karlxia/remoteDataAcquisition/RDAReporte/毕设相关PDF文档/附录PDF/RDApcb.pdf

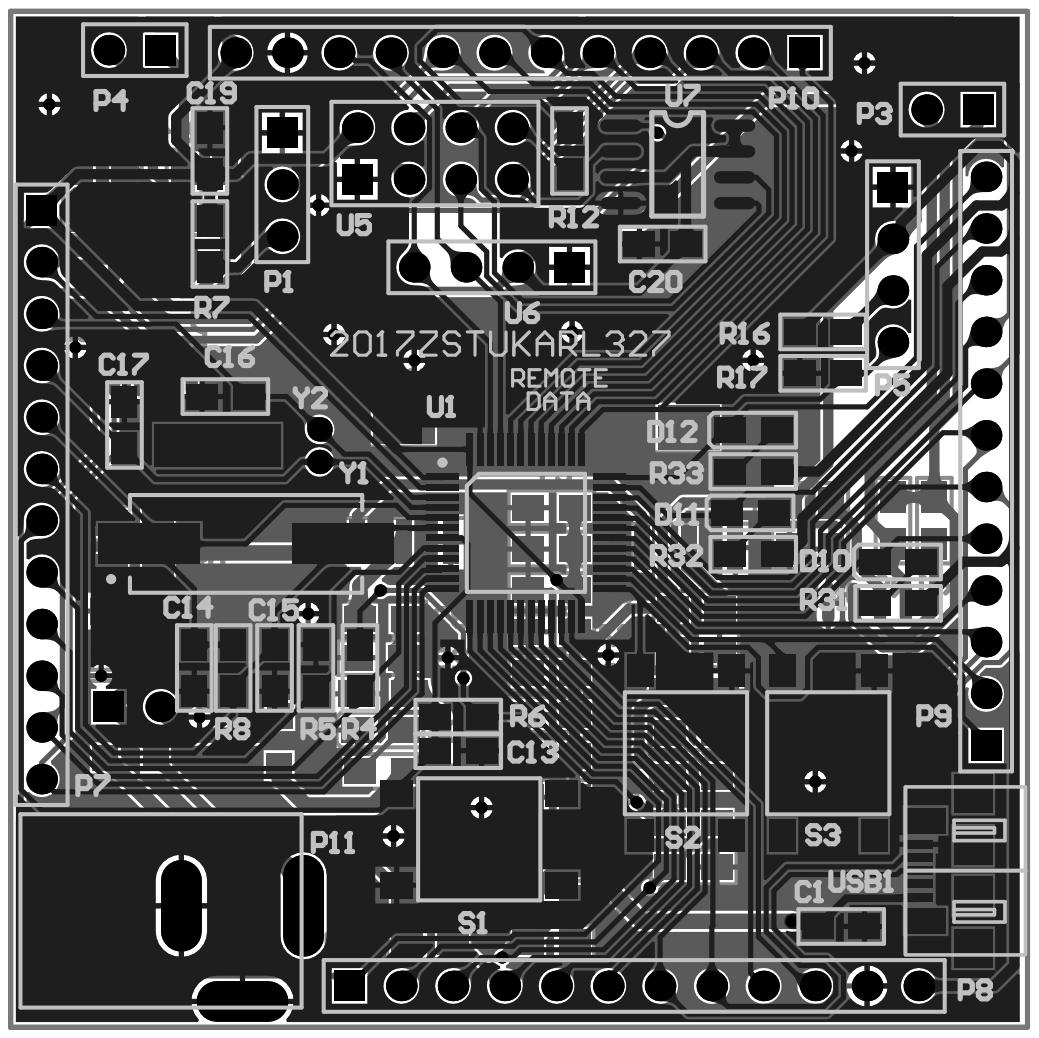
[picture p51: page 1]
