karlxia/remoteDataAcquisition/RDAReporte/毕设相关PDF文档/附录PDF/RDAsch.pdf

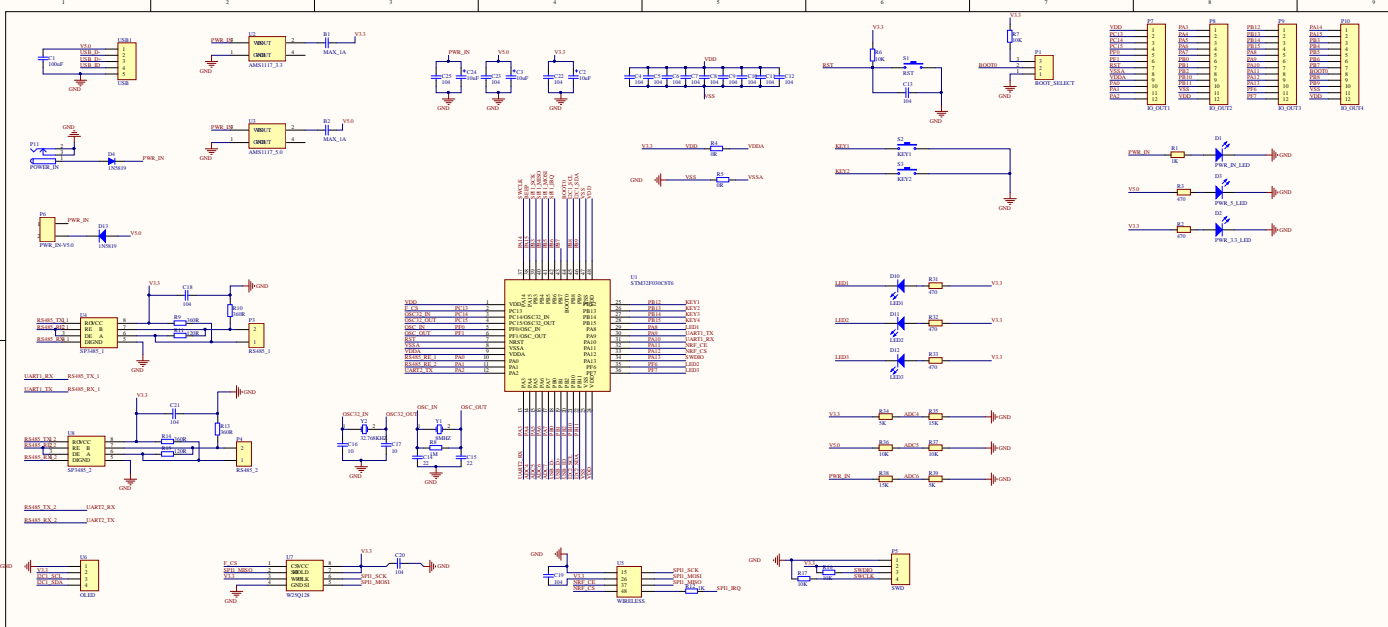
[picture p52: page 1]
