karlxia/remoteDataAcquisition/RDACode/SYSTEM/usart/usart.h

#ifndef __USART_H
#define __USART_H
#include "stdio.h"	
#include "sys.h" 
#include "stm32f0xx_hal.h"
#include "stm32f0xx_karlboard.h"

#define USART_REC_LEN  			200  	//定义最大接收字节数 200

/* Exported types ------------------------------------------------------------*/
/* Exported constants --------------------------------------------------------*/
/* User can use this section to tailor USARTx/UARTx instance used and associated 
   resources */
/* Definition for USARTx clock resources */
#define USARTx                           USART1
#define USARTx_CLK_ENABLE()              __HAL_RCC_USART1_CLK_ENABLE()
#define USARTx_RX_GPIO_CLK_ENABLE()      __HAL_RCC_GPIOA_CLK_ENABLE()
#define USARTx_TX_GPIO_CLK_ENABLE()      __HAL_RCC_GPIOA_CLK_ENABLE()

#define USARTx_FORCE_RESET()             __HAL_RCC_USART1_FORCE_RESET()
#define USARTx_RELEASE_RESET()           __HAL_RCC_USART1_RELEASE_RESET()

/* Definition for USARTx Pins */
#define USARTx_TX_PIN                    GPIO_PIN_9
#define USARTx_TX_GPIO_PORT              GPIOA
#define USARTx_TX_AF                     GPIO_AF1_USART1
#define USARTx_RX_PIN                    GPIO_PIN_10
#define USARTx_RX_GPIO_PORT              GPIOA
#define USARTx_RX_AF                     GPIO_AF1_USART1

/* Definition for USARTx's NVIC */
#define USARTx_IRQn                      USART1_IRQn
#define USARTx_IRQHandler                USART1_IRQHandler
	  	
extern u8  USART_RX_BUF[USART_REC_LEN]; //接收缓冲,最大USART_REC_LEN个字节.末字节为换行符 
extern u16 USART_RX_STA;         		//接收状态标记	
//如果想串口中断接收，请不要注释以下宏定义
void uart_init(u32 bound);
#endif
