karlxia/remoteDataAcquisition/RDACode/USER/main.h

#ifndef __MIAN_H
#define __MIAN_H

/* Includes ------------------------------------------------------------------*/
#include "stm32f0xx_karlboard.h"
#include "oled.h"
#include "rs485.h"

extern uint8_t PHMeterReg;
#endif /* __MIAN_H */
