karlxia/remoteDataAcquisition/RDACode/USER/i2c.h

#include "stm32f0xx_hal.h"
#include "stm32f0xx_hal_i2c.h"

/* Exported types ------------------------------------------------------------*/
/* Exported constants --------------------------------------------------------*/
/* User can use this section to tailor I2Cx/I2Cx instance used and associated
   resources */
/* Definition for I2Cx clock resources */
#define I2Cx                            I2C1
#define RCC_PERIPHCLK_I2Cx              RCC_PERIPHCLK_I2C1
#define RCC_I2CxCLKSOURCE_SYSCLK        RCC_I2C1CLKSOURCE_SYSCLK
#define I2Cx_CLK_ENABLE()               __HAL_RCC_I2C1_CLK_ENABLE()
#define I2Cx_SDA_GPIO_CLK_ENABLE()      __HAL_RCC_GPIOB_CLK_ENABLE()
#define I2Cx_SCL_GPIO_CLK_ENABLE()      __HAL_RCC_GPIOB_CLK_ENABLE() 

#define I2Cx_FORCE_RESET()              __HAL_RCC_I2C1_FORCE_RESET()
#define I2Cx_RELEASE_RESET()            __HAL_RCC_I2C1_RELEASE_RESET()

/* Definition for I2Cx Pins */
#define I2Cx_SCL_PIN                    GPIO_PIN_6
#define I2Cx_SCL_GPIO_PORT              GPIOB
#define I2Cx_SDA_PIN                    GPIO_PIN_7
#define I2Cx_SDA_GPIO_PORT              GPIOB
#define I2Cx_SCL_SDA_AF                 GPIO_AF1_I2C1

/* Definition for I2Cx's NVIC */
#define I2Cx_IRQn                       I2C1_IRQn
#define I2Cx_IRQHandler                 I2C1_IRQHandler

/* Size of Transmission buffer */
#define TXBUFFERSIZE                      (COUNTOF(aTxBuffer) - 1)
/* Size of Reception buffer */
#define RXBUFFERSIZE                      TXBUFFERSIZE

/* Exported macro ------------------------------------------------------------*/
#define COUNTOF(__BUFFER__)   (sizeof(__BUFFER__) / sizeof(*(__BUFFER__)))
/* Exported functions ------------------------------------------------------- */
void I2C_Init(void);
