karlxia/remoteDataAcquisition/RDACode/USER/i2c.c

#include "i2c.h"
/* Private typedef -----------------------------------------------------------*/
/* Private define ------------------------------------------------------------*/
/* Uncomment this line to use the board as master, if not it is used as slave */
//#define MASTER_BOARD
#define I2C_ADDRESS        0x78

/* I2C TIMING Register define when I2C clock source is SYSCLK */
/* I2C TIMING is calculated in case of the I2C Clock source is the SYSCLK = 48 MHz */
/* This example use TIMING to 0x00A51314 to reach 1 MHz speed (Rise time = 100 ns, Fall time = 100 ns) */
#define I2C_TIMING      0x00A51314

/* I2C handler declared in "main.c" file */
extern I2C_HandleTypeDef I2cHandle;
/* Private macro -------------------------------------------------------------*/
/* Private variables ---------------------------------------------------------*/
/* I2C handler declaration */
void I2C_Init(void)
{
	
  /*##-1- Configure the I2C peripheral ######################################*/
  I2cHandle.Instance             = I2Cx;
  I2cHandle.Init.Timing          = I2C_TIMING;
  I2cHandle.Init.OwnAddress1     = I2C_ADDRESS;
  I2cHandle.Init.AddressingMode  = I2C_ADDRESSINGMODE_10BIT;
  I2cHandle.Init.DualAddressMode = I2C_DUALADDRESS_DISABLE;
  I2cHandle.Init.OwnAddress2     = 0xFF;
  I2cHandle.Init.GeneralCallMode = I2C_GENERALCALL_DISABLE;
  I2cHandle.Init.NoStretchMode   = I2C_NOSTRETCH_DISABLE;  
  
  if(HAL_I2C_Init(&I2cHandle) != HAL_OK)
  {
    /* Initialization Error */
   // Error_Handler();
  }
	/* Enable the Analog I2C Filter */
  HAL_I2CEx_ConfigAnalogFilter(&I2cHandle,I2C_ANALOGFILTER_ENABLE);

}

  
