karlxia/remoteDataAcquisition/(commit log)

2017-04-30 add DissolvedOxygenMeter code and correct PHMeter code
    //rs485
    add TX_EN RX_EN to RS485_Send_Data
    //PHMeter
    add PHMeterErrReceiveHandle
    add PHMeterCRCHandle
    correct array data len error
    add CRC verify to ReceiveHandles
    //DissolvedOxygenMeter
    create code based on PHMeter code and DissolvedOxygenMeter protocal
    [DissolvedOxygenMeter.c, DissolvedOxygenMeter.h, PHMeter.c, PHMeter.h, main.c, rs485.c, rs485.h]
2017-05-07 RS485 Communication success for the first time
    successed in reading data from DOMeter and receive error message while
    writing register.
    [DissolvedOxygenMeter.c, DissolvedOxygenMeter.h, PHMeter.c, PHMeter.h, main.c, rs485.c]
2017-05-07 finish DOMeter drive
    resolved bugs in writing register in DOMeter
    [DissolvedOxygenMeter.c, DissolvedOxygenMeter.h, main.c]
2017-05-08 optimaze display & success communicating with 2 device
