karlxia/remoteDataAcquisition/(notices)

Notices in the files:
RDACode/Hardware/OLED/oled.h:
Copyright(C) ÖÐ¾°Ô°µç×Ó2014/3/16
All rights reserved
